bharathajay51/gem-sorter-mdf/Manufacturing & Packing/PDF/Parts List.pdf

Kit1 check list | Kriya

Batch 1 (15-08-2025)

Item code | Item Name | SKU Photo | Stock Quantity | Remarks

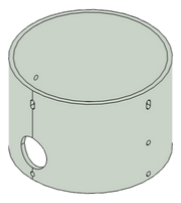
[picture p1: figure]

1 | Pipe | | 1

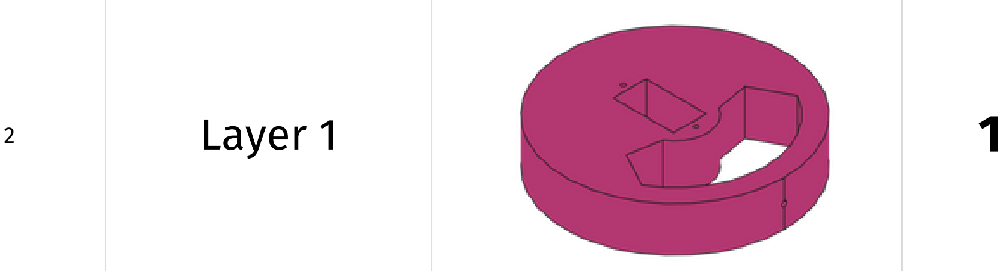
[picture p2: figure]
Layer 1
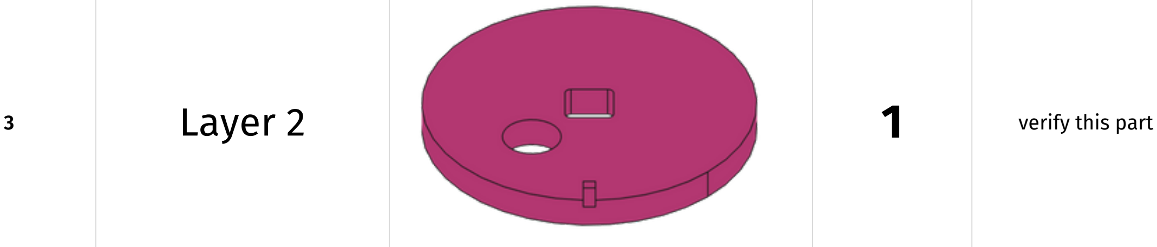
[picture p3: figure]
Layer 2; verify this part

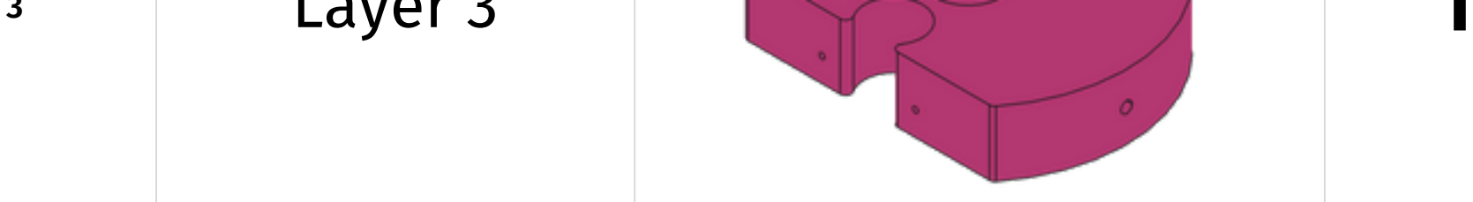
[picture p4: figure]
Layer 3
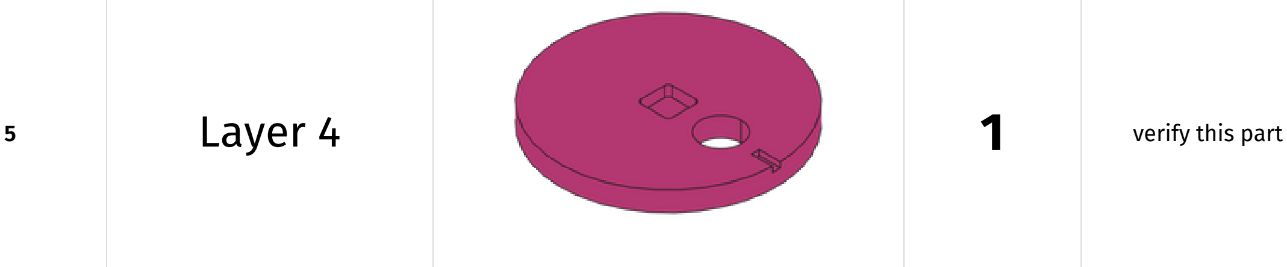
[picture p5: figure]
Layer 4; verify this part
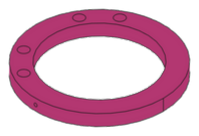
[picture p6: figure]

6 | Layer 5 | 1

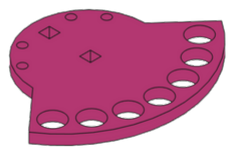
[picture p7: figure]

7 | Layer 6 | 1
8 | Servo Legs | 2

9 | Dowel | 4

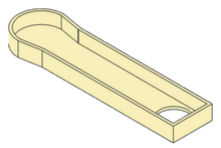
[picture p8: figure]

10 | Plastic Slide | 1
11 | Slide Mount | 1
12 | Shaft | 1
13 | Testube | 7

15 | Servo | 2

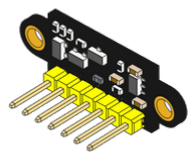
[picture p9: figure]

15 | Color Sensor | 1

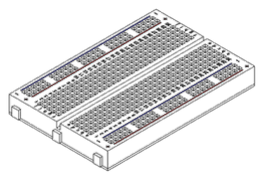
[picture p10: figure]

17 | Bread Board | 1

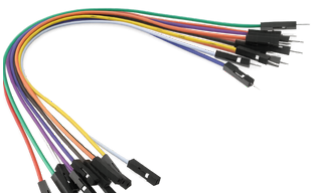
[picture p11: figure]

18

Male to Male
Jumper

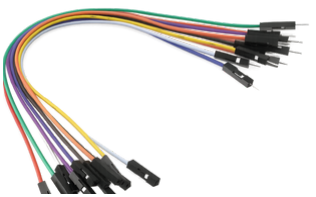
[picture p12: figure]

19

Male to Female
jumper

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
