bharathajay51/gem-sorter-mdf/FreeCad/Slide Mount.FCStd

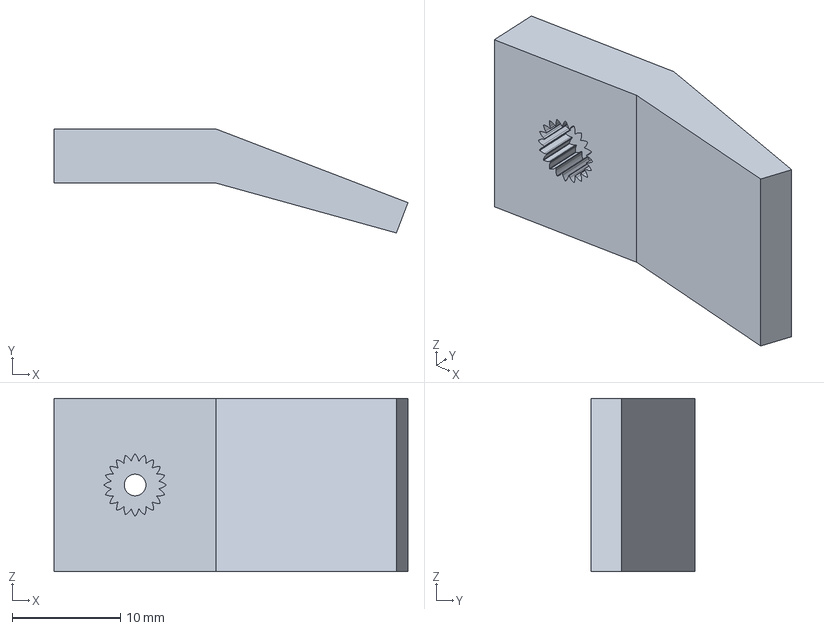
[picture p13: CAD file, 2026-09-21]
FreeCad/Slide Mount.FCStd
32.7 x 9.61 x 16.0 mm
