bharathajay51/gem-sorter-mdf/FreeCad/step-files/Socket.step

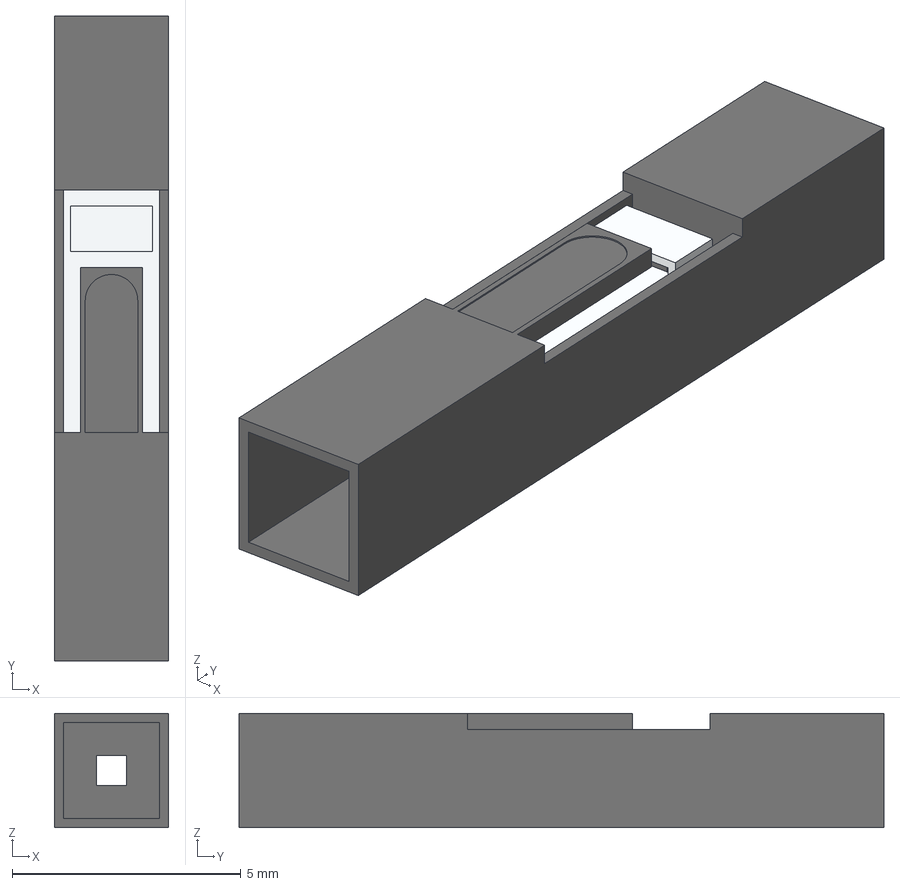
[picture p14: CAD file, 2026-01-27]
FreeCad/step-files/Socket.step
2.50 x 14.1 x 2.50 mm
Header
Blok
Header/Header-wire
