bharathajay51/gem-sorter-mdf/Manufacturing & Packing/Jigs/Freecad/Top Servo Layer Jig.FCStd

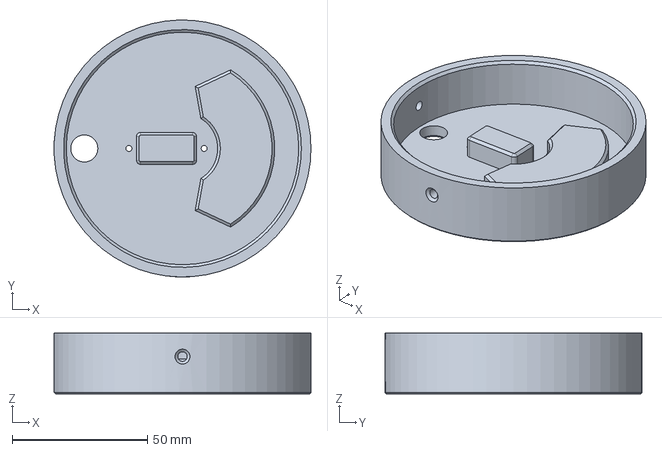
[picture p15: CAD file, 2026-01-10]
Manufacturing & Packing/Jigs/Freecad/Top Servo Layer Jig.FCStd
95.0 x 95.0 x 22.5 mm
