bharathajay51/gem-sorter-mdf/STL/Servo Shaft New.stl

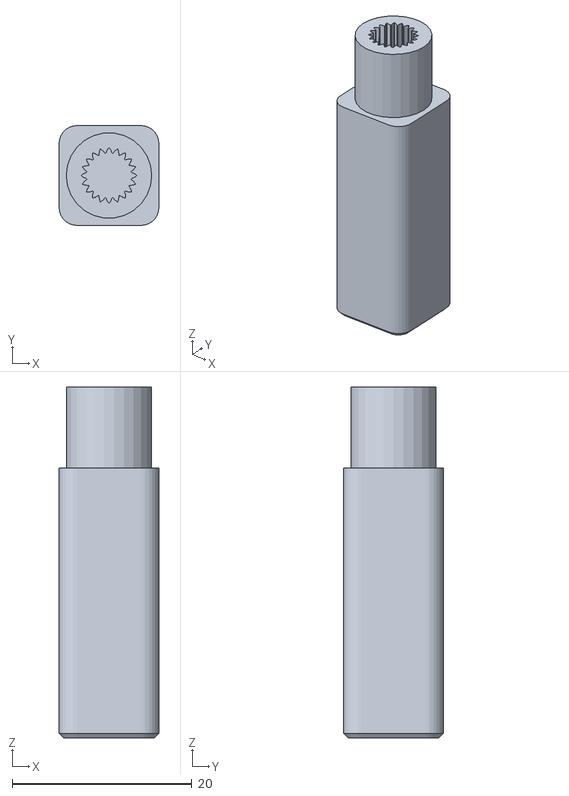
[picture p16: CAD file, 2025-08-26]
STL/Servo Shaft New.stl
11.1 x 11.1 x 39.0
