bharathajay51/gem-sorter-mdf/STL/Sliced for bambu/Servo Shaft 5.3mf

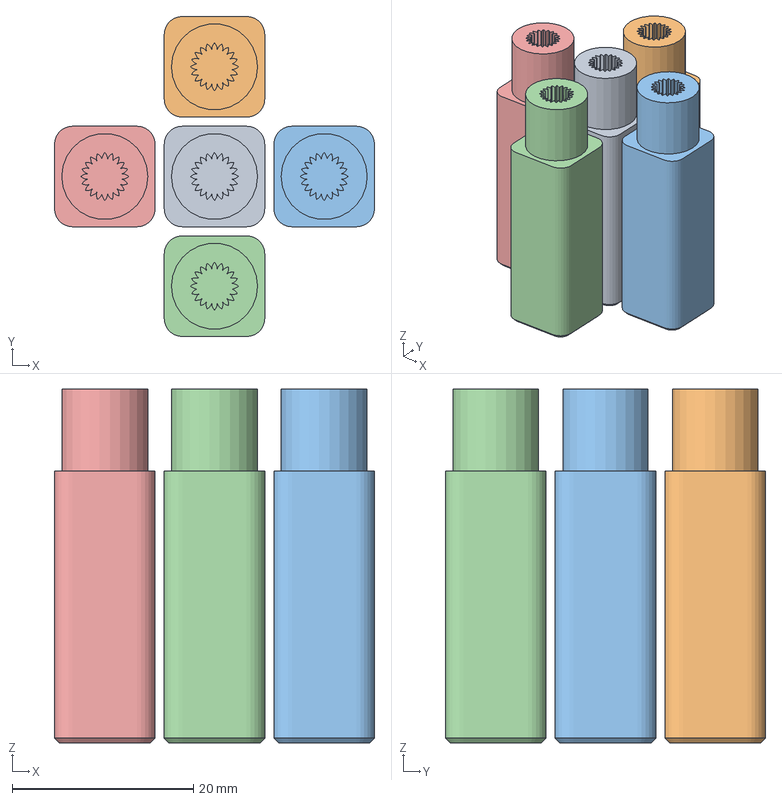
[picture p17: CAD file, 2025-09-06]
STL/Sliced for bambu/Servo Shaft 5.3mf
35.3 x 35.3 x 39.0 mm
Servo Shaft Multi Print-Cut.stl x 5
