bharathajay51/gem-sorter-mdf/FreeCad/Slide.FCStd

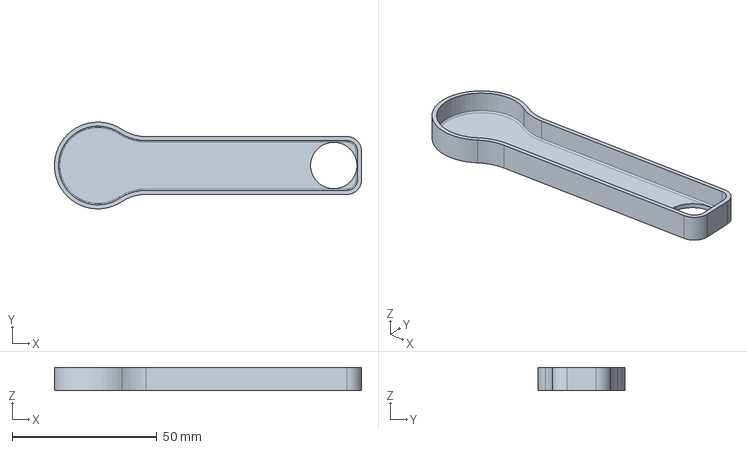
[picture p18: CAD file, 2026-09-21]
FreeCad/Slide.FCStd
106.1 x 30.0 x 8.00 mm
