bharathajay51/gem-sorter-mdf/FreeCad/step-files/Pin.step

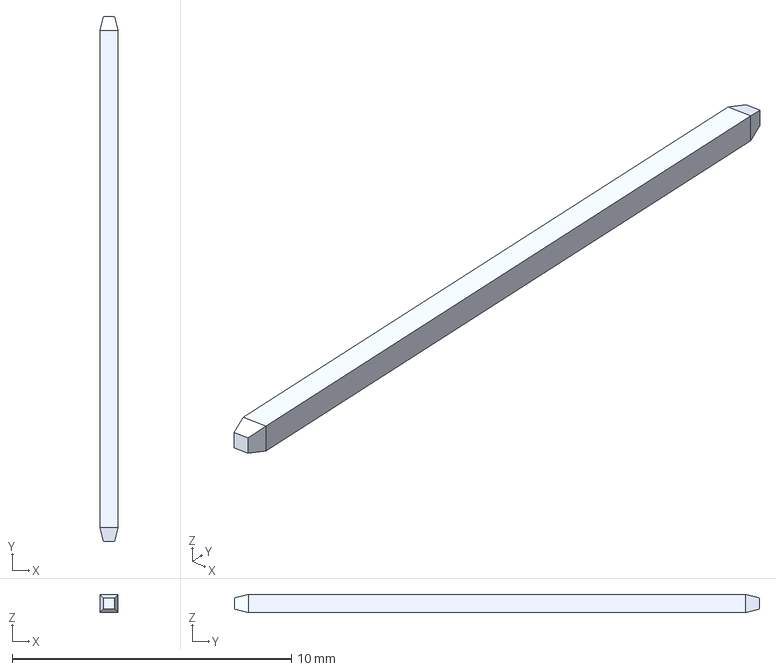
[picture p19: CAD file, 2026-01-27]
FreeCad/step-files/Pin.step
0.65 x 18.8 x 0.65 mm
