bharathajay51/gem-sorter-mdf/Manufacturing & Packing/Jigs/Freecad/Bottom Layer Jig.FCStd

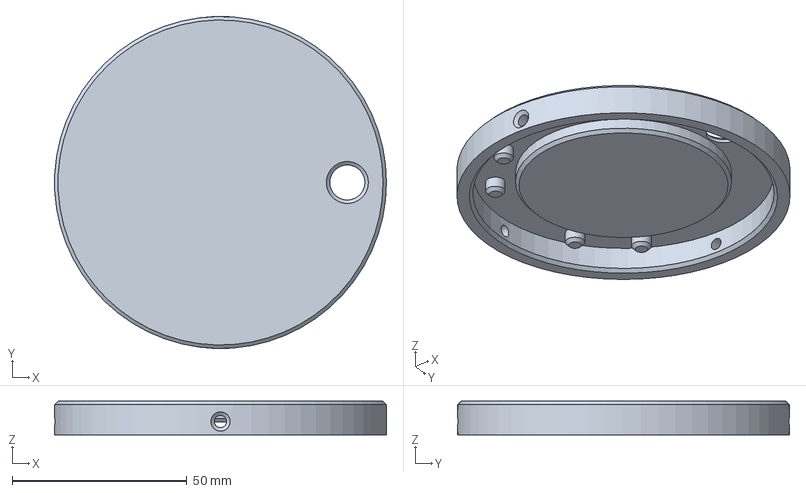
[picture p20: CAD file, 2025-08-05]
Manufacturing & Packing/Jigs/Freecad/Bottom Layer Jig.FCStd
95.0 x 95.0 x 9.60 mm
