bharathajay51/gem-sorter-mdf/STL/Gems Sorter-slide.stl

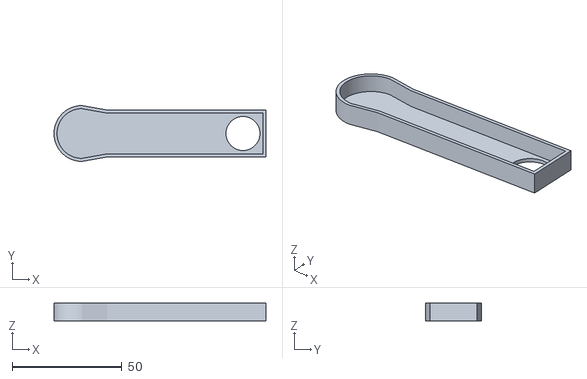
[picture p21: CAD file, 2025-07-23]
STL/Gems Sorter-slide.stl
96.7 x 25.5 x 8.00
