bharathajay51/gem-sorter-mdf/FreeCad/step-files/Wire.step

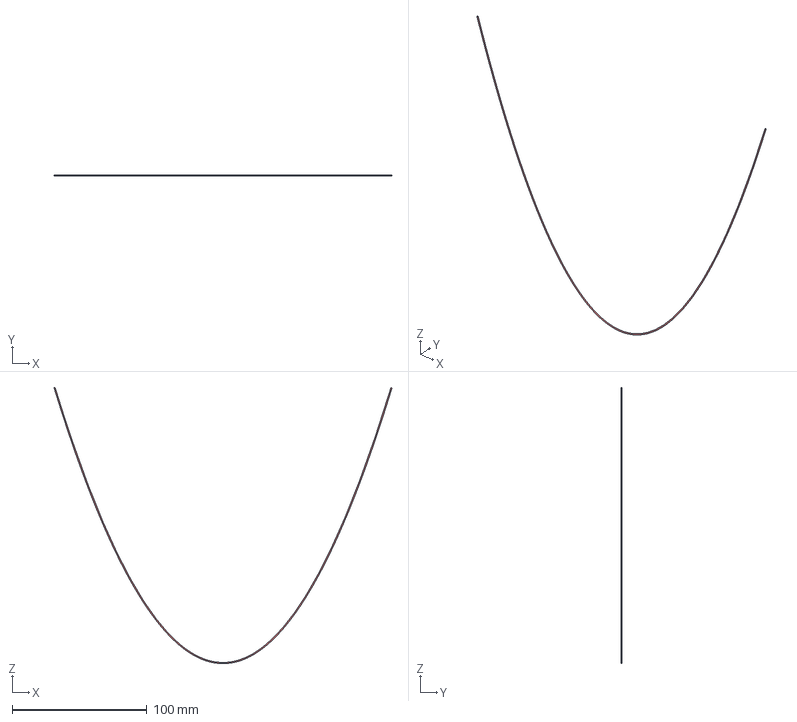
[picture p22: CAD file, 2026-01-27]
FreeCad/step-files/Wire.step
250.8 x 0.9 x 205.0 mm
15cm
20cm
30cm
50cm
