bharathajay51/gem-sorter-mdf/Manufacturing & Packing/Jigs/Freecad/Colour Sensor Layer Jig.FCStd

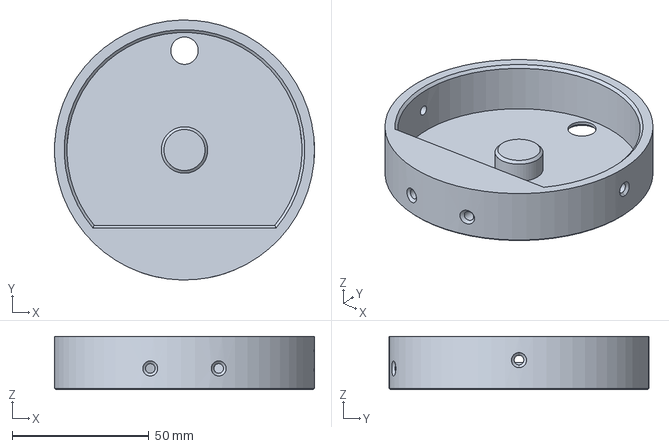
[picture p23: CAD file, 2025-08-05]
Manufacturing & Packing/Jigs/Freecad/Colour Sensor Layer Jig.FCStd
95.0 x 95.0 x 19.5 mm
