bharathajay51/gem-sorter-mdf/STL/Pipe 90.stl

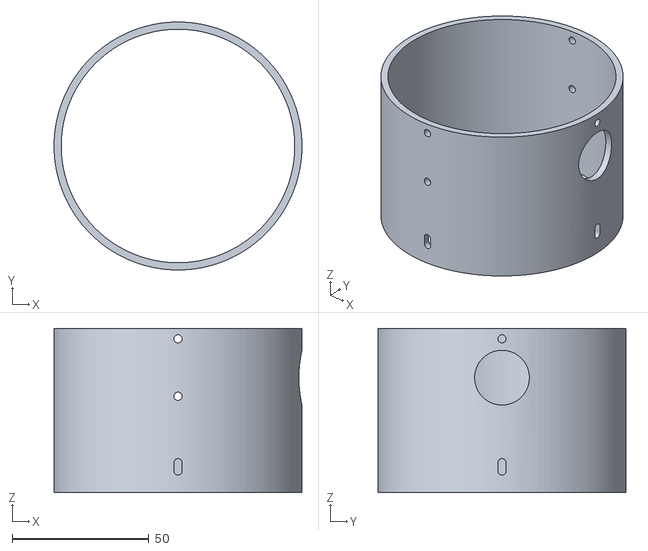
[picture p24: CAD file, 2025-05-17]
STL/Pipe 90.stl
90.6 x 90.6 x 60.0
