bharathajay51/gem-sorter-mdf/FreeCad/step-files/1x7 Male Pin Header.STEP

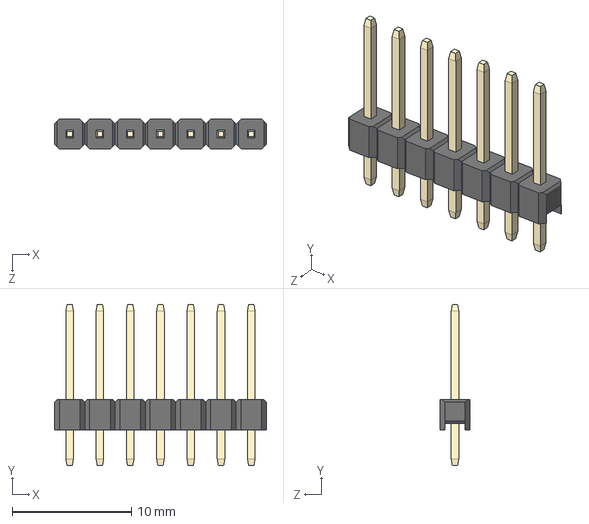
[picture p25: CAD file, 2025-07-23]
FreeCad/step-files/1x7 Male Pin Header.STEP
17.8 x 13.5 x 2.50 mm
