bharathajay51/gem-sorter-mdf/Manufacturing & Packing/Jigs/Freecad/Pipe Jig.FCStd

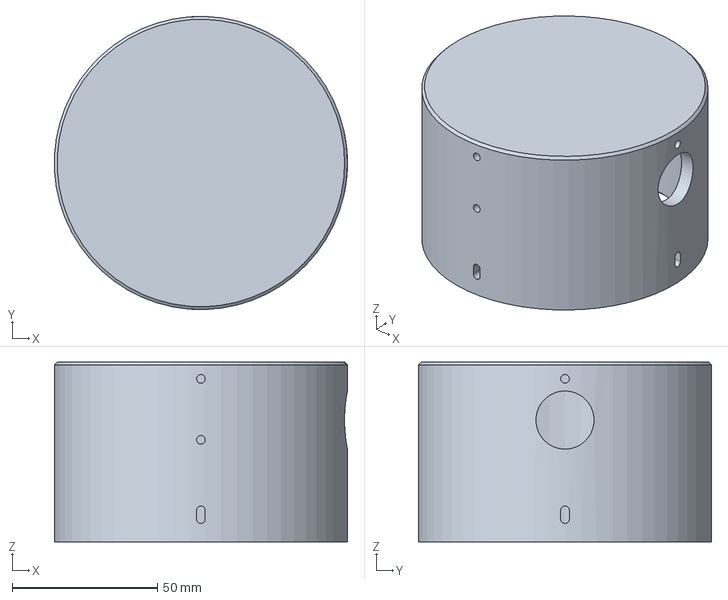
[picture p26: CAD file, 2025-08-05]
Manufacturing & Packing/Jigs/Freecad/Pipe Jig.FCStd
100.9 x 101.0 x 62.0 mm
