bharathajay51/gem-sorter-mdf/FreeCad/Gems Sorter.FCStd

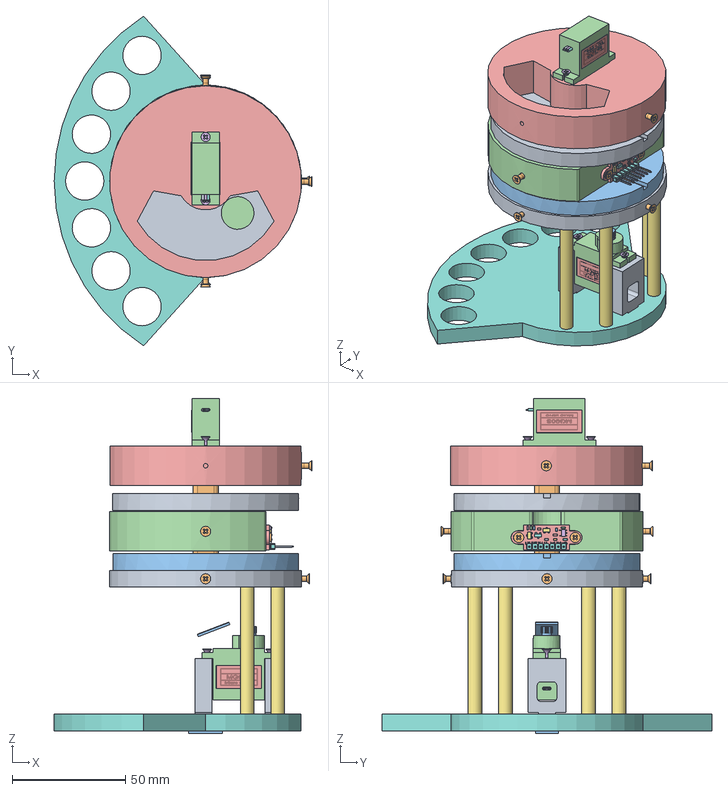
[picture p27: CAD file, 2026-01-12]
FreeCad/Gems Sorter.FCStd
114.0 x 145.9 x 148.2 mm
ring_spacer
#3x3/8in-Screw x 9
second_layer
color_sensor_layer
3472 v5
3472 v006
3472 v007
3472 v008
3472 v009
3472 v010
3472 v011
3472 v012
3472 v013
3472 v014
3472 v015
3472 v016
3472 v017
3472 v018
3472 v019
3472 v020
3472 v021
3472 v022
3472 v023
3472 v024
3472 v025
3472 v026
3472 v027
3472 v028
3472 v029
3472 v030
3472 v031
3472 v032
3472 v033
3472 v034
3472 v035
3472 v036
3472 v037
3472 v038
3472 v039
3472 v040
3472 v041
3472 v042
3472 v043
3472 v044
3472 v045
3472 v046
3472 v047
3472 v048
3472 v049
3472 v050
3472 v051
3472 v052
3472 v053
3472 v054
3472 v055
3472 v056
3472 v057
3472 v058
3472 v059
3472 v060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
