bharathajay51/gem-sorter-mdf/FreeCad/step-files/SG90.step

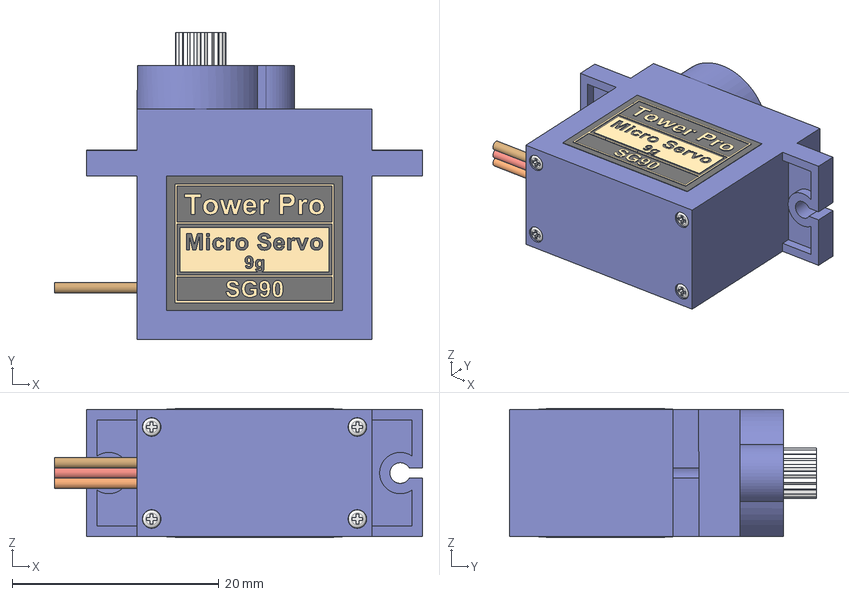
[picture p28: CAD file, 2025-05-19]
FreeCad/step-files/SG90.step
35.6 x 29.7 x 12.5 mm
