bharathajay51/gem-sorter-mdf/Manufacturing & Packing/Jigs/Freecad/Servo Leg Jig.FCStd

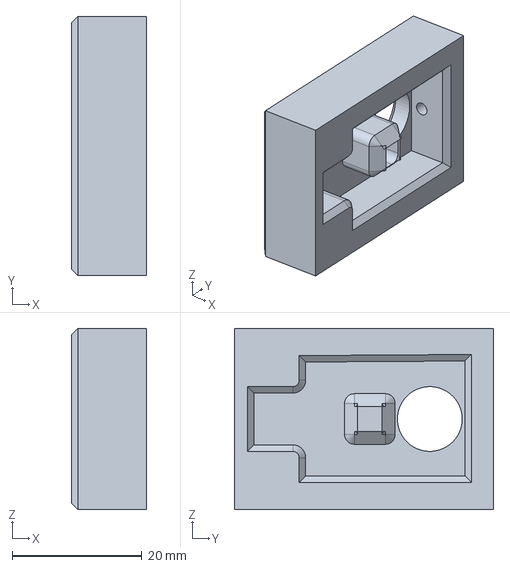
[picture p29: CAD file, 2025-05-17]
Manufacturing & Packing/Jigs/Freecad/Servo Leg Jig.FCStd
11.6 x 40.0 x 28.0 mm
