bharathajay51/gem-sorter-mdf/FreeCad/testube.FCStd

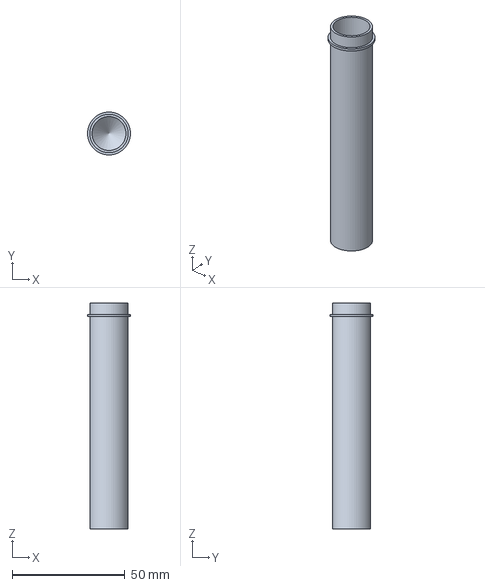
[picture p30: CAD file, 2026-01-12]
FreeCad/testube.FCStd
19.0 x 19.0 x 100.0 mm
