bharathajay51/gem-sorter-mdf/FreeCad/pipe_injection.FCStd

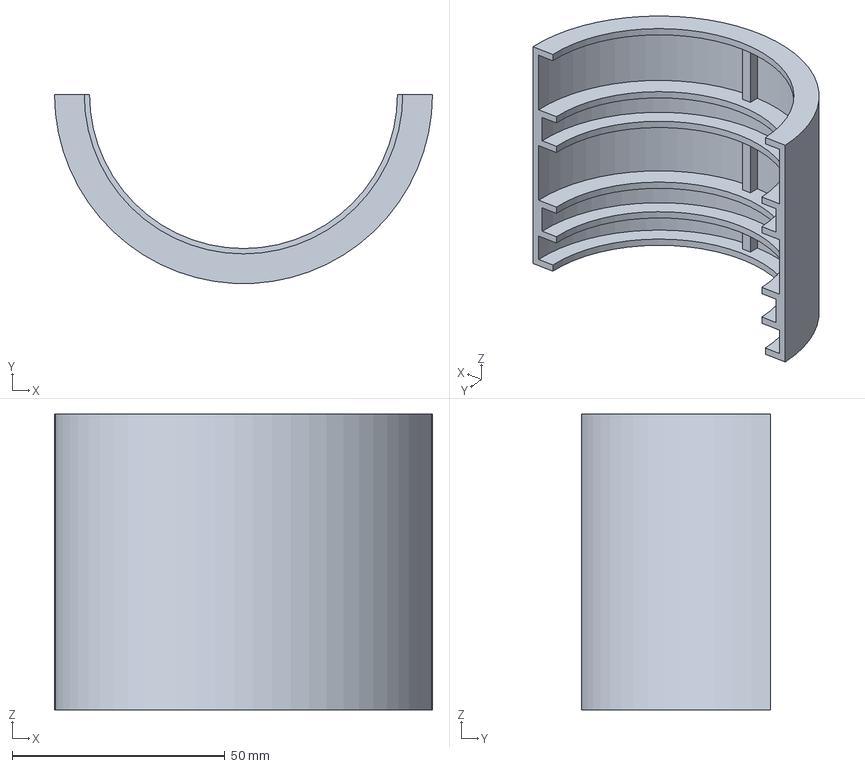
[picture p31: CAD file, 2026-01-12]
FreeCad/pipe_injection.FCStd
88.9 x 44.4 x 69.5 mm
