bharathajay51/gem-sorter-mdf/FreeCad/Light to tripod.FCStd

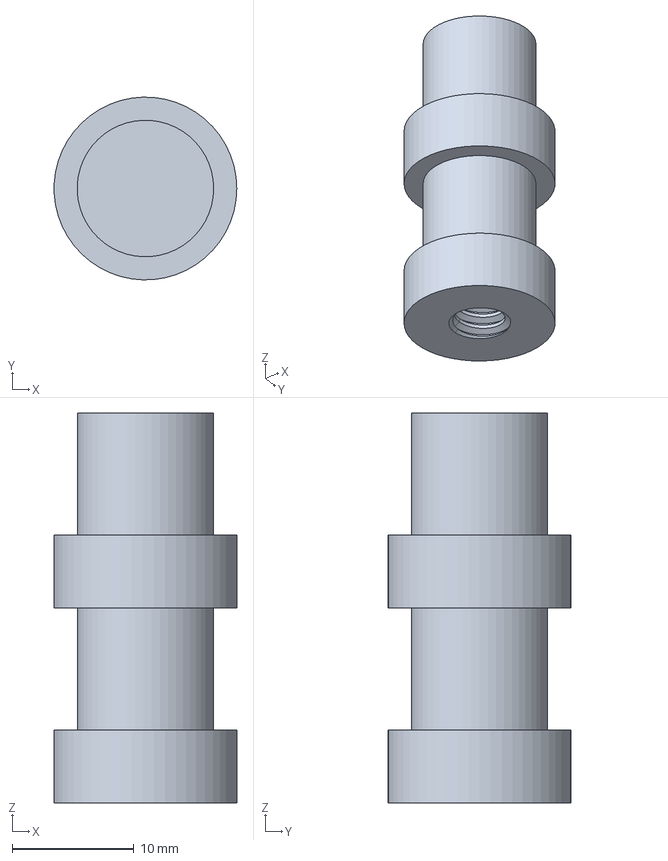
[picture p32: CAD file, 2026-01-10]
FreeCad/Light to tripod.FCStd
15.0 x 15.0 x 32.0 mm
