bharathajay51/gem-sorter-mdf/FreeCad/Servo Shaft.FCStd

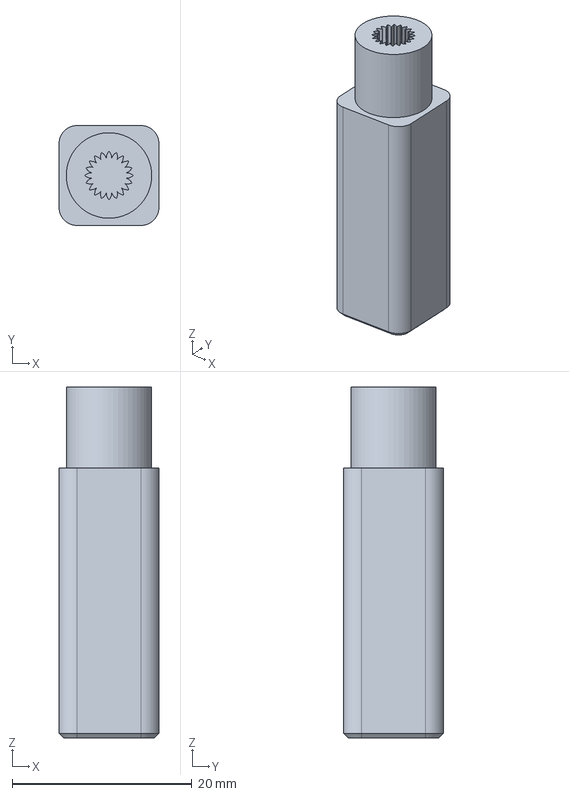
[picture p33: CAD file, 2025-09-06]
FreeCad/Servo Shaft.FCStd
11.1 x 11.1 x 39.0 mm
