bharathajay51/gem-sorter-mdf/(list of files, cad)

Other CAD files:
FreeCad/Pipe.FCStd
FreeCad/Servo Shaft Multi Print.FCStd
FreeCad/container.FCStd
FreeCad/Parametric Screw Top Container.FCStd
FreeCad/Pipe copy.FCStd
FreeCad/step-files/TCS34727.step
Manufacturing & Packing/Jigs/STL/Bottom Layer Jig.stl
Manufacturing & Packing/Jigs/STL/Colour Sensor Layer Jig.stl
Manufacturing & Packing/Jigs/STL/Pipe Jig.stl
Manufacturing & Packing/Jigs/STL/Servo Leg Jig.stl
Manufacturing & Packing/Jigs/STL/Top Servo Layer Jig.stl
STL/Servo Shaft.stl
STL/Slide Mount.stl
