bharathajay51/gem-sorter-mdf/Manufacturing & Packing/PDF/MDF Post Processing.pdf

# MDF Post Processing

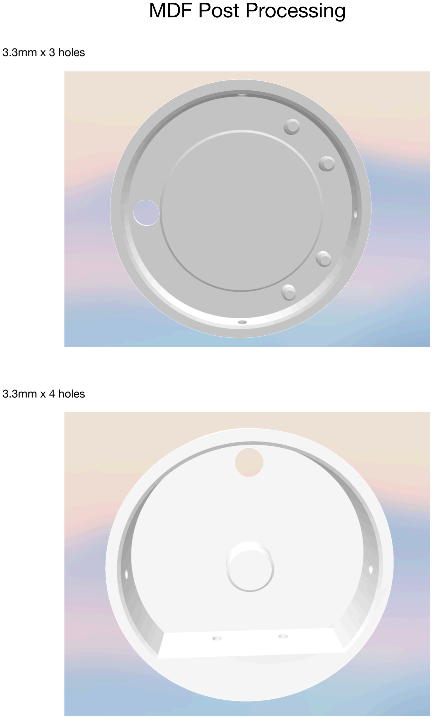
[picture p34: page 1]

3.3mm x 3 holes

3.3mm x 4 holes

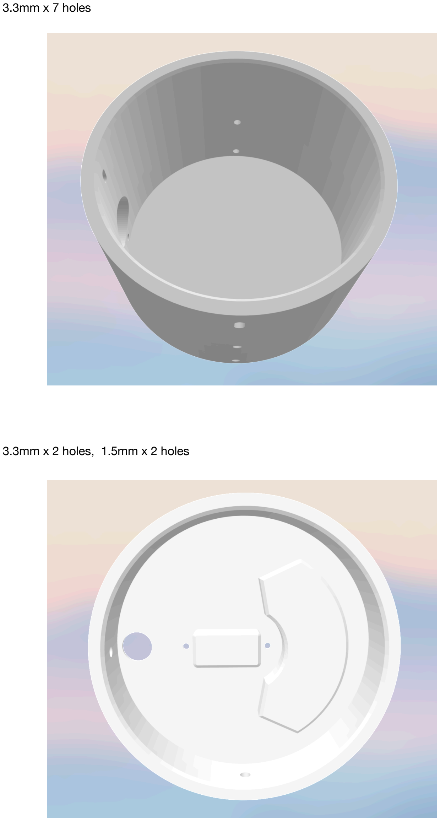
[picture p35: page 2]

3.3mm x 7 holes

3.3mm x 2 holes, 1.5mm x 2 holes

1.5mm x 1 holes

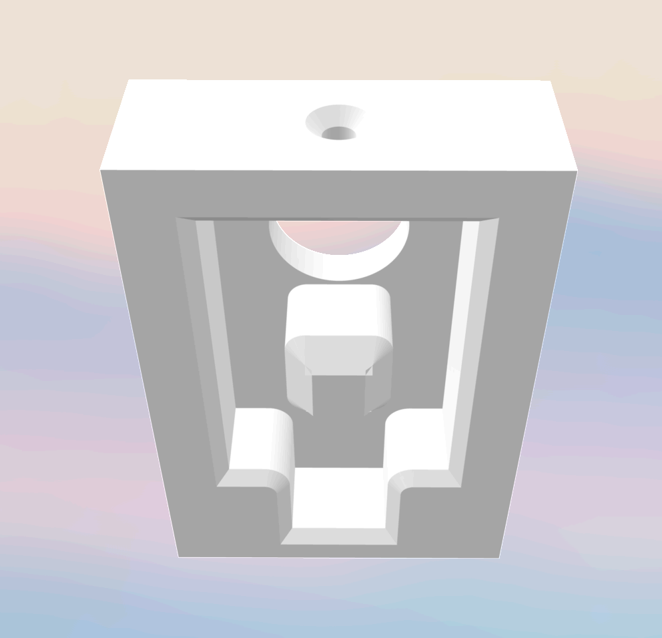
[picture p36: figure]
