bharathajay51/gem-sorter-mdf/(list of files, drawings)

Other design files:
Fritzig/Homing.fzz
Fritzing/Colour Sensor - Chameleon.fzz
Fritzing/Colour Sensor Wiring.fzz
Fritzing/Homing.fzz
