bharathajay51/gem-sorter-mdf/(commit log)

2025-05-06 Organized files
    [Bottom Layer Jig.FCStd, Bottom Layer Jig.stl, Colour Sensor Layer Jig.FCStd, Colour Sensor Layer Jig.stl, Gems Sorter.FCStd, Pipe.FCStd, Servo Leg Jig.FCStd, Servo Leg Jig.stl]
2025-05-06 Organized into folders
    [Gems Sorter.FCStd, Pipe.FCStd, Servo Shaft.FCStd, Slide Mount.FCStd, Slide.FCStd, gem_sorter_mdf 11.13.53 AM.FCStd]
2025-05-08 cleanup, bugfix
    [Slide Mount.FCStd, Slide Mount.stl]
2025-05-10 cleanup and changed Pipe Dia
    [Gems Sorter.FCStd, Pipe.FCStd, Slide Mount.FCStd]
2025-05-13 Servo hole modified for top layer
    [Gems Sorter.FCStd]
2025-05-17 Final updates
    [Bottom Layer Jig.FCStd, Bottom Layer Jig.stl, Colour Sensor Layer Jig.FCStd, Colour Sensor Layer Jig.stl, Gems Sorter.FCStd, Pipe 90.stl, Servo Leg Jig.FCStd, Servo Leg Jig.stl]
2025-05-17 square hole to 8.1mm
    [Gems Sorter.FCStd, Pipe.FCStd, Slide Mount.FCStd]
2025-05-19 Full assembly
    [Gems Sorter.FCStd, Pipe.FCStd, SG90.step, Slide Mount.FCStd, TCS34727.step]
2025-06-14 Visual changes
    [Gems Sorter.FCStd, Parametric Screw Top Container.FCStd, container.FCStd, testube.FCStd]
2025-07-23 Added slide stl and color sensor header
    [1x7 Male Pin Header.STEP, Gems Sorter-slide.stl, Gems Sorter.FCStd, Pipe.FCStd]
2025-08-05 Updated Jigs
    [Bottom Layer Jig.FCStd, Bottom Layer Jig.stl, Colour Sensor Layer Jig.FCStd, Colour Sensor Layer Jig.stl, Homing.fzz, Pipe Jig.FCStd, Pipe Jig.stl, Top Servo Layer Jig.FCStd]
2025-08-05 removed unwanted files
    [Unnamed-BodyPocket.stl, Unnamed.FCStd]
2025-08-26 Code update
    [Homing.fzz, Servo Shaft New.stl, Servo Shaft.FCStd, Slide Mount.FCStd]
2025-08-31 Changed servo names
    [Servo Shaft.FCStd]
2025-08-31 fix servo angles on new servo
2025-09-06 code change
    [Servo Shaft 5.3mf, Servo Shaft Multi Print.FCStd, Servo Shaft.FCStd, Slide.FCStd]
2026-01-10 Code fix
    [Bottom Layer Jig.FCStd, Bottom Layer Jig.stl, Colour Sensor Layer Jig.FCStd, Colour Sensor Layer Jig.stl, Colour Sensor Wiring.fzz, Light to tripod.FCStd, Pipe Jig.FCStd, Pipe Jig.stl]
2026-01-12 New steps
    [Gems Sorter.FCStd, Parametric Screw Top Container.FCStd, Pipe.FCStd, Slide Mount.FCStd, Slide.FCStd, pipe_injection.FCStd, testube.FCStd]
2026-01-27 Wiring added
    [1x7 Male Pin Header.STEP, Pin.step, SG90.step, Socket.step, TCS34727.step, Wire.step]
2026-03-13 Add side projects and candy sorter with clean explainer comments
    Adds colour_picker, chameleon_lamp, sorter_rgb_led, sorter_web_ui,
    wifi_led_controller, and candy_sorter projects. All comments cleaned
    to be end-user explainers only — removed fix references, historical
    change notes, and workaround details for final release.
    [candy_sorter.ino, chameleon_lamp.ino, colour_picker.ino, sorter_rgb_led.ino, sorter_web_ui.ino, wifi_led_controller.ino]
